ricearcane/ti_contest/Pictures/Haptic_subsystem.jpg

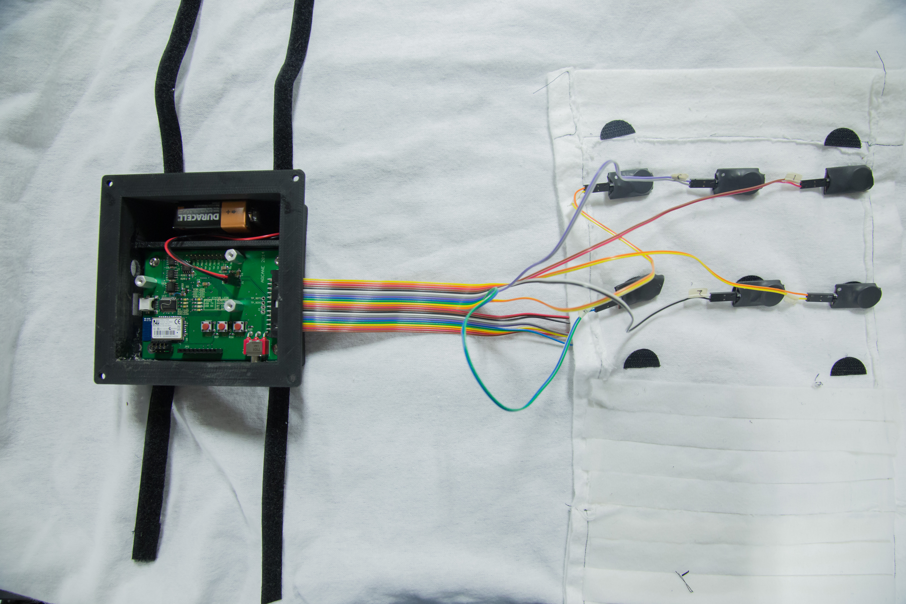
Pictures/Haptic_subsystem.jpg
