ricearcane/ti_contest/README.md

ti_contest
==========

Files for the 2014 TI Analog Design Competition
