ricearcane/ti_contest/Pictures/Stereo_cameras.jpg

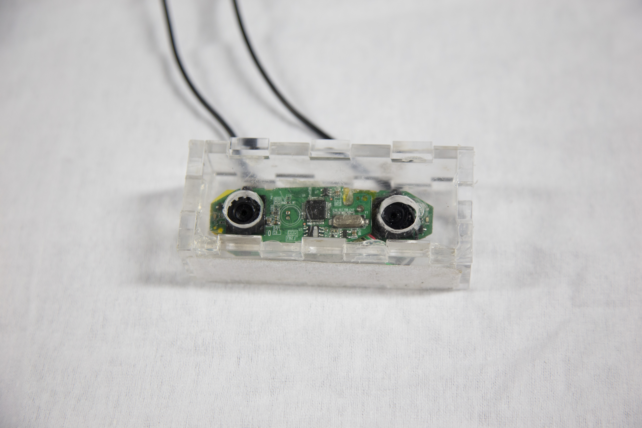
Pictures/Stereo_cameras.jpg
