ricearcane/ti_contest/Hardware/BOMs/battery_charger_bom.xlsx

Value | Device | Package | Parts | Description | Qty | Digikey Part Number | Customer Reference
10m | R-US_R2010 | R2010 | R17 | RESISTOR, American symbol | 1 | RHM.010ASCT-ND | R17
50m | R-US_R2010 | R2010 | R20 | RESISTOR, American symbol | 1 | CSRN2010FK50L0CT-ND | R20
2 | R-US_R2512 | R2512 | R6 | RESISTOR, American symbol | 1 | PT2.0YCT-ND | R6
10 | R-US_R1206 | R1206 | R16 | RESISTOR, American symbol | 1 | 311-10.0FRCT-ND | R16
100 | R-US_R0603 | R0603 | R13 | RESISTOR, American symbol | 1 | 311-100GRCT-ND | R13
1k | R-US_R0603 | R0603 | R15, R18 | RESISTOR, American symbol | 5 | 311-1.00KHRCT-ND | R15, R18 | Extras for LEDs
2.2k | R-US_R0603 | R0603 | R11 | RESISTOR, American symbol | 1 | 311-2.20KHRCT-ND | R11
6.8k | R-US_R0603 | R0603 | R12 | RESISTOR, American symbol | 1 | 311-6.80KHRCT-ND | R12
10k | R-US_R0603 | R0603 | R1, R2, R3 | RESISTOR, American symbol | 3 | 311-10KGRCT-ND | R1, R2, R3
25k | R-US_R0603 | R0603 | R5 | RESISTOR, American symbol | 1 | PNM0603-25KBCT-ND | R5
34k | R-US_R0603 | R0603 | R8 | RESISTOR, American symbol | 1 | RMCF0603FT34K0CT-ND | R8
100k | R-US_R0603 | R0603 | R4, R7, R9, R10, R14, R19, R22 | RESISTOR, American symbol | 7 | 311-100KHRCT-ND | R4, R7, R9, R10, R14, R19, R22
300k | R-US_R0603 | R0603 | R21 | RESISTOR, American symbol | 1 | P300KHCT-ND | R21
22p | C-EUC0603 | C0603 | C17 | CAPACITOR, European symbol | 1 | 445-5366-1-ND | C17
.1u | C-EUC0603 | C0603 | C3, C4, C5, C6, C9, C11, C12, C13, C14 | CAPACITOR, European symbol | 9 | 399-7844-1-ND | C3, C4, C5, C6, C9, C11, C12, C13, C14
1u | C-EUC0603 | C0603 | C2, C7, C10 | CAPACITOR, European symbol | 3 | 587-2400-1-ND | C2, C7, C10
2.2u | C-EUC0603 | C0603 | C1 | CAPACITOR, European symbol | 1 | 445-8025-1-ND | C1
10u | C-EUC0805 | C0805 | C8, C15, C16, C18 | CAPACITOR, European symbol | 4 | 445-11516-1-ND | C8, C15, C16, C18
8.2uH | IHLP-2525CZ-01 | IHLP-2525CZ | L1 |  | 1 | 541-1012-1-ND | L1
Amber | LEDCHIPLED_0805 | LEDCHIPLED_0805 | LED3 | LED | 1 | 516-1431-1-ND | LED3
Blue | LEDCHIPLED_0805 | LEDCHIPLED_0805 | LED1 | LED | 1 | 160-1645-1-ND | LED1
Green | LEDCHIPLED_0805 | CHIPLED_0805 | LED2 | LED | 1 | 160-1423-1-ND | LED2
BAT54C | BAT54C | SOT23 | D1 | Schottky Diodes | 1 | BAT54CT-ND | D1
BQ24630 | BQ24630 | PVQFN-24 | U1 |  | 1 | 296-25761-1-ND | U1
SI7617DN | SI7617DN | POWERPAK1212-8 | Q1, Q2, Q5 |  | 3 | SI7617DN-T1-GE3CT-ND | Q1, Q2, Q5
SIS412DN | SIS412DN | POWERPAK1212-8 | Q3, Q4 |  | 2 | SIS412DN-T1-GE3CT-ND | Q3, Q4
 | 733980-62 | 733980-62 | X1 | FEMALE PRINT CONNECTOR | 1 | CP-047A-ND | X1
 | PINHD-1X2 | 1X02 | JP2, JP3 | PIN HEADER | 2 |  | JP2, JP3
BATTERY | PINHD-1X3 | 1X03 | JP1 | PIN HEADER | 1 |  | JP1
