ricearcane/ti_contest/Hardware/BOMs/integrated_board_bom.xlsx

Value | Device | Package | Parts | Description | Qty | Digikey Part Number | Customer Reference | Notes
1 | R-US_R0805 | R0805 | R6, R7, R8, R9, R10, R11, R12, R13, R14, R15, R16, R17 | RESISTOR, American symbol | 12 | RMCF0805JT1R00CT-ND | R6, R7, R8, R9, R10, R11, R12, R13, R14, R15, R16, R17
330 | R-US_R0603 | R0603 | R20, R21, R22 | RESISTOR, American symbol | 3 | 1276-5050-1-ND | R20, R21, R22
470 | R-US_R0603 | R0603 | R4, R18, R19, R30, R31, R32 | RESISTOR, American symbol | 6 | 311-470GRCT-ND | R4, R18, R19, R30, R31, R32
1.24k | R-US_R0603 | R0603 | R5 | RESISTOR, American symbol | 1 | P1.24KHCT-ND | R5
4.7k | R-US_R0603 | R0603 | R25, R26, R28, R29 | RESISTOR, American symbol | 4 | 311-4.7KGRCT-ND | R25, R26, R28, R29
10k | R-US_R0603 | R0603 | R27, R33 | RESISTOR, American symbol | 2 | 311-10KGRCT-ND | R27, R33
91k | R-US_R0603 | R0603 | R3 | RESISTOR, American symbol | 1 | 311-91.0KHRCT-ND | R3
100k | R-US_R0603 | R0603 | R1 | RESISTOR, American symbol | 1 | 311-100KGRCT-ND | R1
284k | R-US_R0603 | R0603 | R2 | RESISTOR, American symbol | 1 | RR08P284KDCT-ND | R2
4.7k | CTS742C083 | CTS742C083 | RN1 | Chip Resistor Array 4 Single Resistor | 1 | TC164J-4.7KCT-ND | RN1
0.1uF | C-USC0805K | C0805K | C5, C6, C7, C9, C10, C12, C13 | CAPACITOR, American symbol | 7 | 311-1361-1-ND | C5, C6, C7, C9, C10, C12, C13
1uF | C-EUC0805K | C0805K | C3, C4 | CAPACITOR, European symbol | 2 | 1276-1029-1-ND | C3, C4
10uF | C-USC1206K | C1206K | C1 | CAPACITOR, American symbol | 1 | 587-1353-1-ND | C1
22uF | C-USC1206K | C1206K | C2, C8, C11 | CAPACITOR, American symbol | 3 | 1276-3048-1-ND | C2, C8, C11
2.2uH | L-USL2520P | L2520P | L1 | INDUCTOR, American symbol | 1 | 445-3670-1-ND | L1
Amber | LEDCHIP-LED0805 | CHIP-LED0805 | LED8 | LED | 1 | 516-1431-1-ND | LED8
Blue | LEDCHIP-LED0805 | CHIP-LED0805 | LED4 | LED | 1 | 160-1645-1-ND | LED4
Green | LEDCHIP-LED0805 | CHIP-LED0805 | LED3,LED7 | LED | 2 | 160-1423-1-ND | LED3,LED7
Red | LEDCHIP-LED0805 | CHIP-LED0805 | LED1, LED2, LED6, LED9 | LED | 4 | 160-1415-1-ND | LED1, LED2, LED6, LED9
White | LEDCHIP-LED0805 | CHIP-LED0805 | LED5 | LED | 1 | 160-1738-1-ND | LED5
23K256 | 23K256 | SOIC8 | U8, U9 |  | 2 | 23K256-I/SN-ND | U8, U9
24FC512 | 24FC512 | SOIC8 | U10 |  | 1 | 24FC512-I/SN-ND | U10
FT232RL | FT232RL | SSOP28 | U13 |  | 1 | 768-1007-1-ND | U13
P8X32A-Q44 | Propeller | P8X32A-Q44 | U11 |  | 1 | P8X32A-Q44-ND | U11
RN-42 | Bluetooth Module | RN-42 | U6 |  | 1 | 740-1038-ND | U6
SST25VF040B | SST25VF040B | SOIC8 | U12 |  | 1 | 804-25VF040B5CSAF | U12 | MOUSER PART
TLC59711 | TLC59711 | TLC59711 | U3 |  | 1 | 296-36745-1-ND | U3
TPD6E05U06 | TPD6E05U06 | PUQFN-N14 | U2, U4 | TPD6E05U06 6-channel ESD Protection device | 2 | N/A | U2, U4 | New product - need to sample from TI
TPS62160 | TPS62160 | VSSOP | U1 |  | 1 | 296-30318-1-ND | U1
2524-5 | 2524-5 | PAK100/2500-5-24 | J3 | 3M (TM) Pak 100 4-Wall Header | 1 | MHE24K-ND | J3
1X02 Header Male | PINHD-1X2 | 1X02 | J1, J2 | PIN HEADER | 2 |  | J1, J2
1X09 Header | PINHD-1X9 | 1X09 | JP2 | PIN HEADER | 1 |  | JP2
 | JP4Q | JP4Q | JP1 | JUMPER | 4 | 3M9580-ND | JP1
 | PUSHBUTTON | 6MMX6MM | SW1, SW2, SW3 |  | 3 | 450-1804-ND | SW1, SW2, SW3
 | 7101MD9AQE | 7101MD9A | S1 | TOGGLE SWITCH | 1 | CKN1047-ND | S1
5MHz | CRYSTALHC49UP | HC49UP | Q1 | CRYSTAL | 1 | XC1264CT-ND | Q1
SOT23-3904 | MMBT918LT1-NPN-SOT23-BEC | SOT23-BEC | Q2 | NPN Transistror | 1 | MMBT918LT1GOSCT-ND | Q2
USB-MINI_B | USB-MINI_B | USB_MINI_B | J4 | MINI USB-B Conector | 1 | H2959CT-ND | J4
