ricearcane/ti_contest/Hardware/Battery Charger/charger_brd.pdf

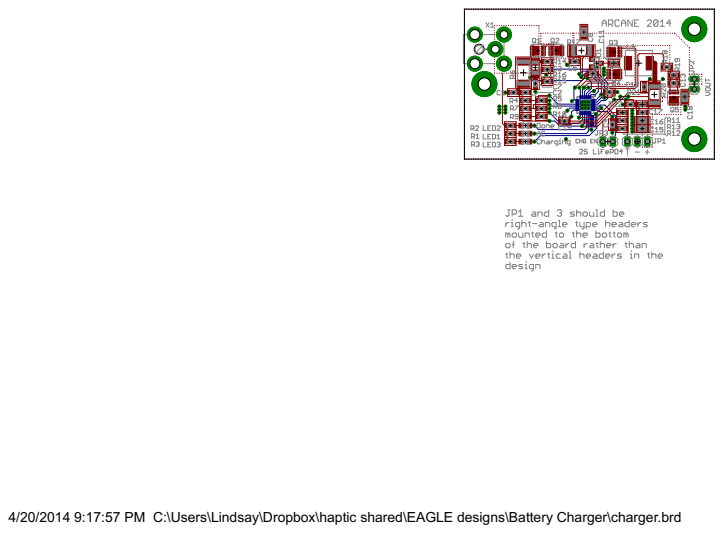
[picture p28: page 1]

4/20/2014 9:17:57 PM C:\Users\Lindsay\Dropbox\haptic shared\EAGLE designs\Battery Charger\charger.brd
