ricearcane/ti_contest/Hardware/Battery Charger/charger_sch.pdf

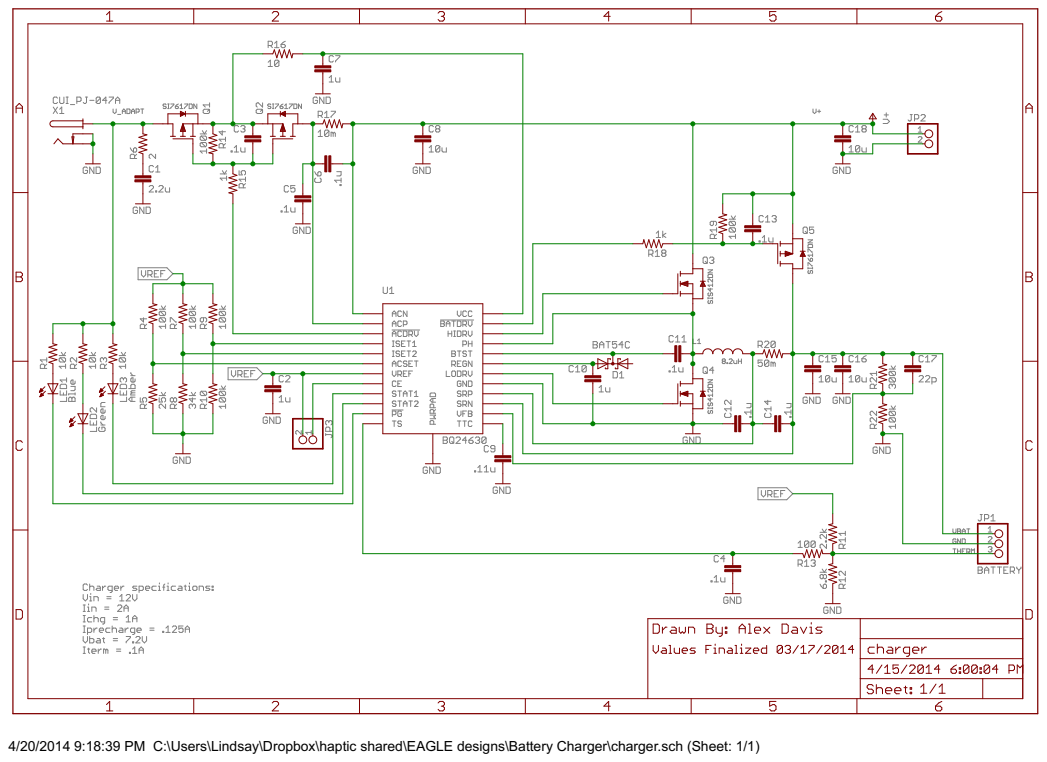
[picture p29: page 1]

4/20/2014 9:18:39 PM C:\Users\Lindsay\Dropbox\haptic shared\EAGLE designs\Battery Charger\charger.sch (Sheet: 1/1)
