ricearcane/ti_contest/Hardware/Integrated haptic system/integrated_haptic_brd.pdf

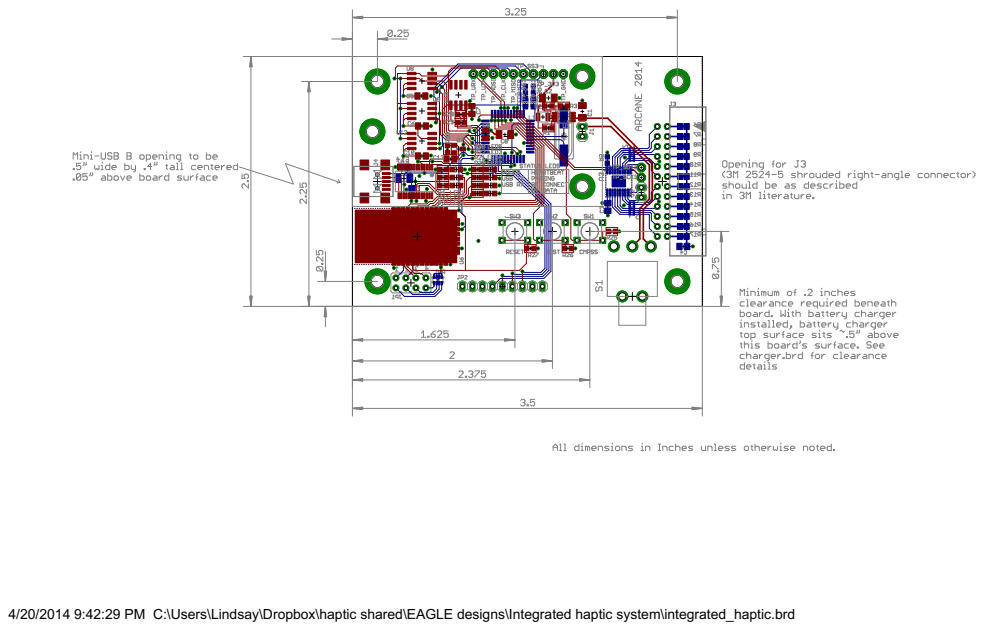
[picture p30: page 1]

4/20/2014 9:42:29 PM C:\Users\Lindsay\Dropbox\haptic shared\EAGLE designs\Integrated haptic system\integrated_haptic.brd
