ricearcane/ti_contest/Hardware/Integrated haptic system/integrated_haptic_sch.pdf

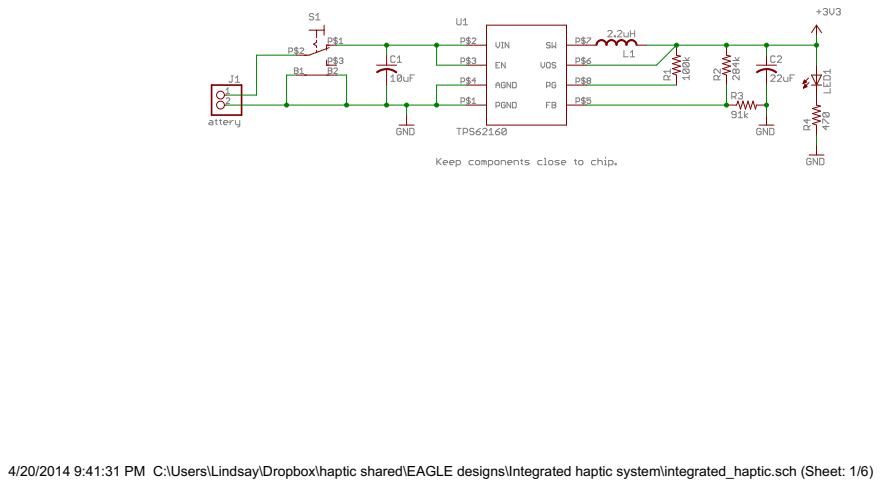
[picture p31: page 1]

4/20/2014 9:41:31 PM C:\Users\Lindsay\Dropbox\haptic shared\EAGLE designs\Integrated haptic system\integrated_haptic.sch (Sheet: 1/6)

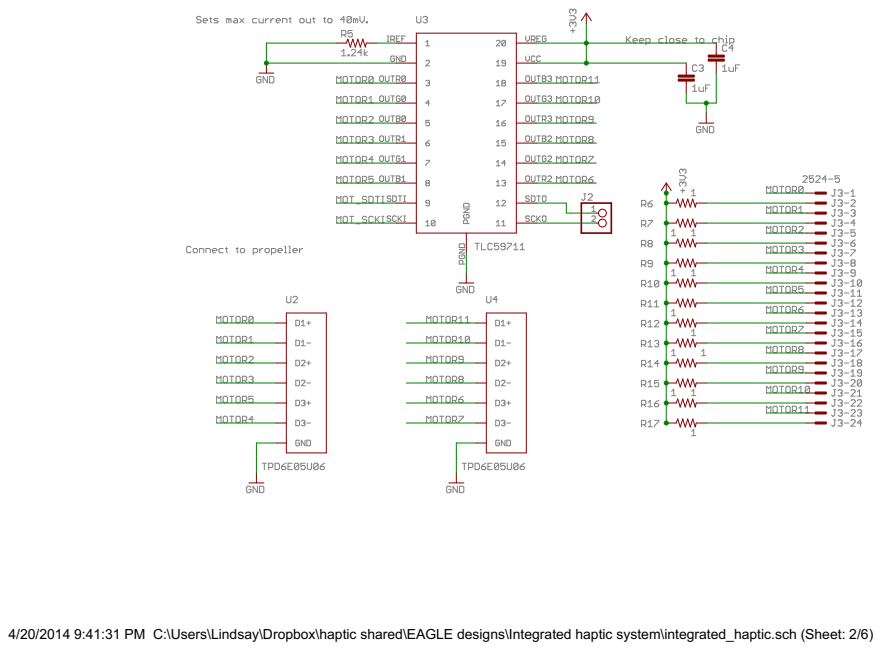
[picture p32: page 2]

4/20/2014 9:41:31 PM C:\Users\Lindsay\Dropbox\haptic shared\EAGLE designs\Integrated haptic system\integrated_haptic.sch (Sheet: 2/6)

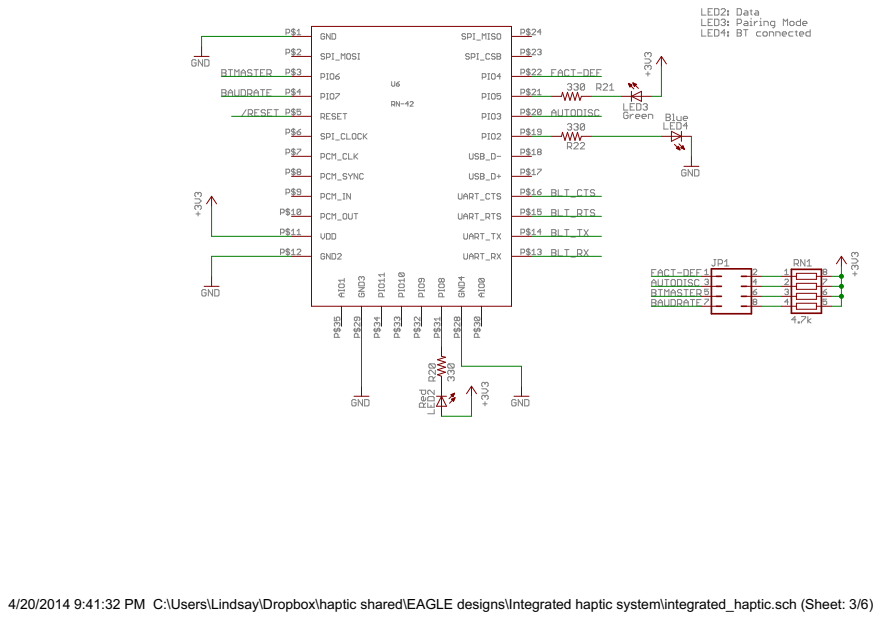
[picture p33: page 3]

4/20/2014 9:41:32 PM C:\Users\Lindsay\Dropbox\haptic shared\EAGLE designs\Integrated haptic system\integrated_haptic.sch (Sheet: 3/6)

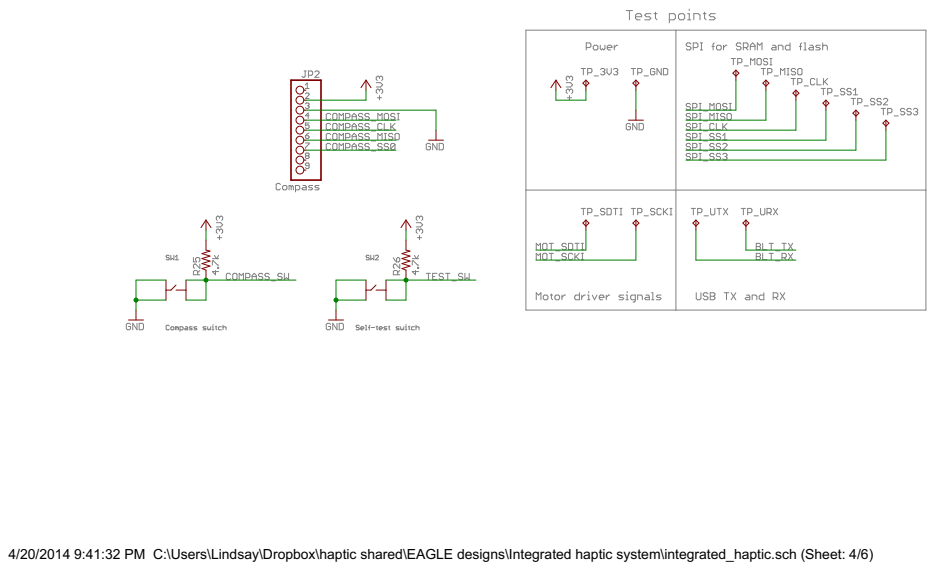
[picture p34: page 4]

4/20/2014 9:41:32 PM C:\Users\Lindsay\Dropbox\haptic shared\EAGLE designs\Integrated haptic system\integrated_haptic.sch (Sheet: 4/6)

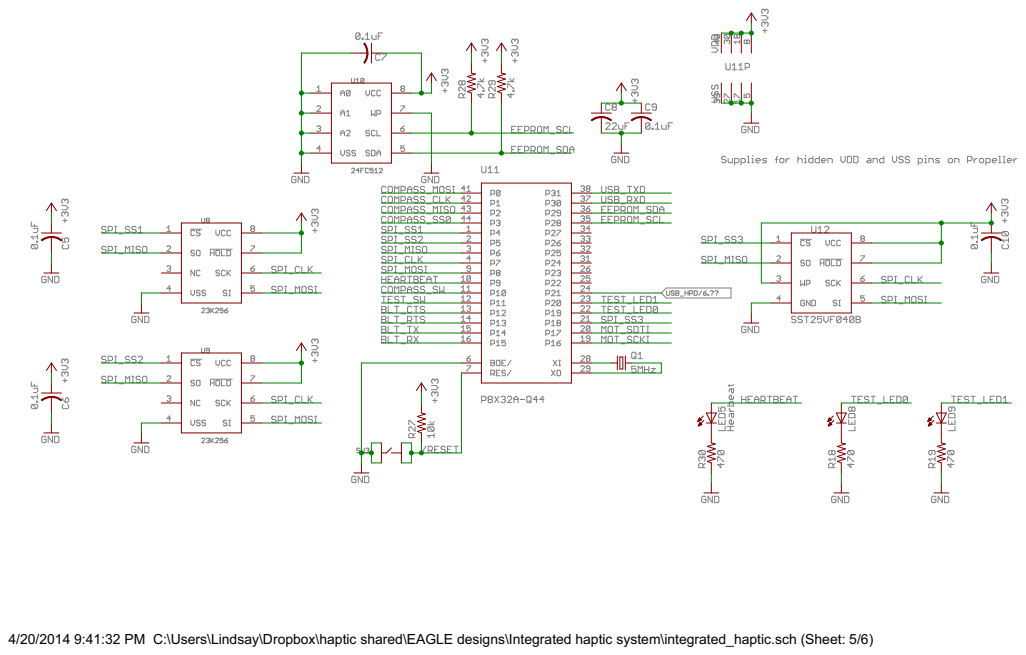
[picture p35: page 5]

4/20/2014 9:41:32 PM C:\Users\Lindsay\Dropbox\haptic shared\EAGLE designs\Integrated haptic system\integrated_haptic.sch (Sheet: 5/6)

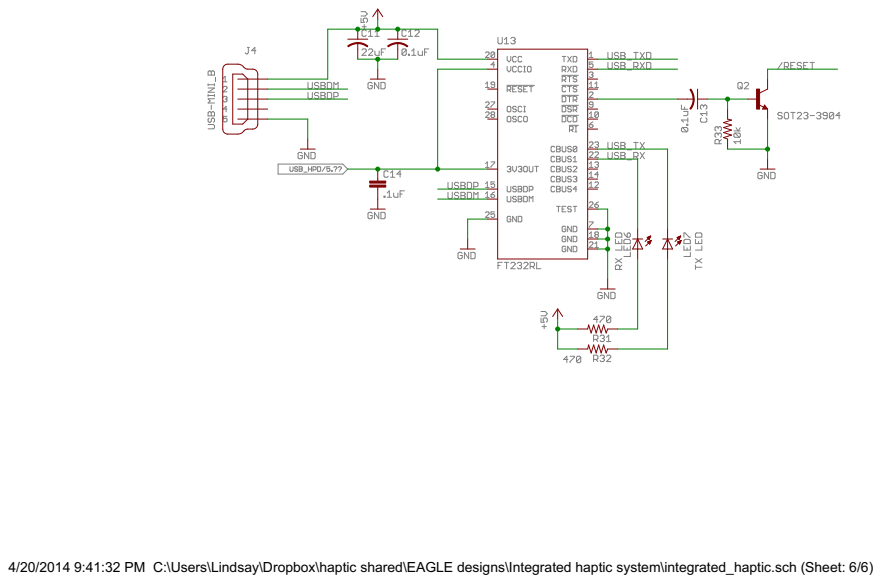
[picture p36: page 6]

4/20/2014 9:41:32 PM C:\Users\Lindsay\Dropbox\haptic shared\EAGLE designs\Integrated haptic system\integrated_haptic.sch (Sheet: 6/6)
