ricearcane/ti_contest/Hardware/Motor Coupons/coupon-brd.pdf

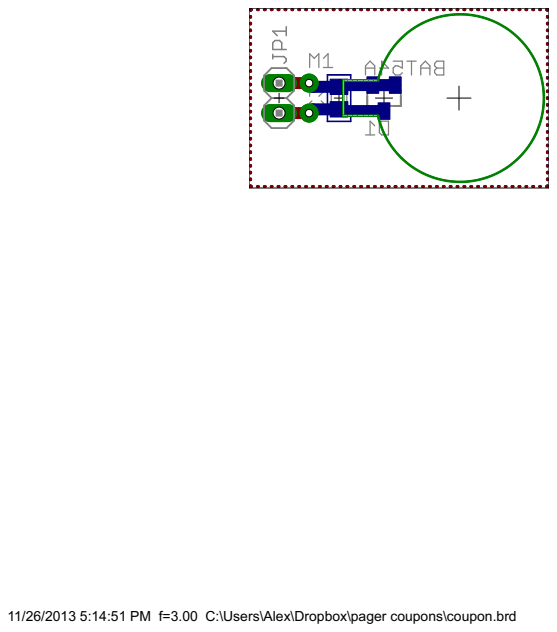
[picture p37: page 1]

11/26/2013 5:14:51 PM f=3.00 C:\Users\Alex\Dropbox\pager coupons\coupon.brd
