ricearcane/ti_contest/Hardware/Motor Coupons/coupon-sch.pdf

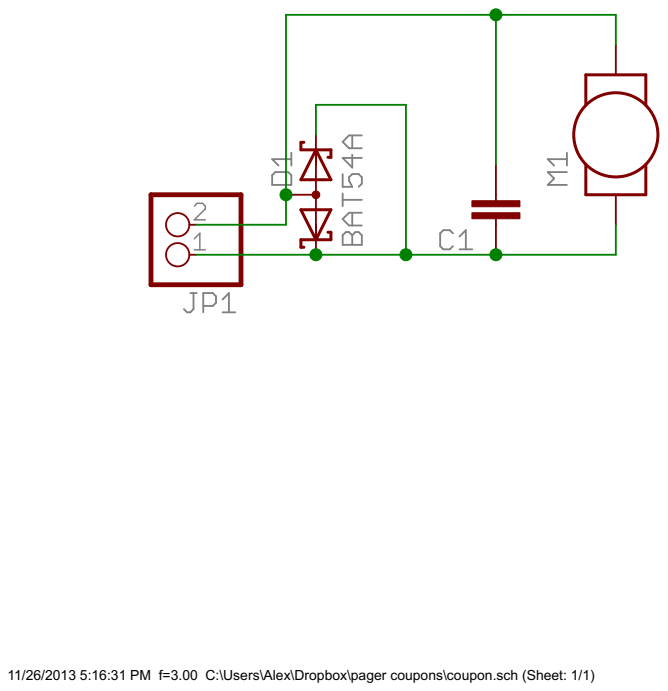
[picture p38: page 1]

11/26/2013 5:16:31 PM f=3.00 C:\Users\Alex\Dropbox\pager coupons\coupon.sch (Sheet: 1/1)
