ricearcane/ti_contest/Hardware/Motor Coupons/coupon.brd

## EAGLE design Hardware/Motor Coupons/coupon.brd (2014-05-25)

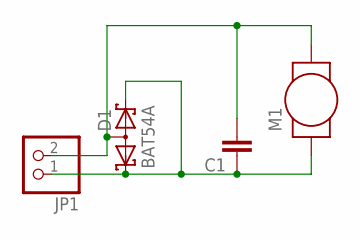
[picture p39: schematic coupon.sch]

Parts:
C1: C-EUC0805; C0805
D1: BAT54A; SOT23
JP1: PINHD-1X2; 1X02
M1: PAGER-PANCAKE; PANCAKE

Connections:
GND: C1.1, D1.1 (K1), D1.2 (K2), JP1.1, M1.P$1
unnamed: C1.2, D1.3 (AA), JP1.2, M1.P$2

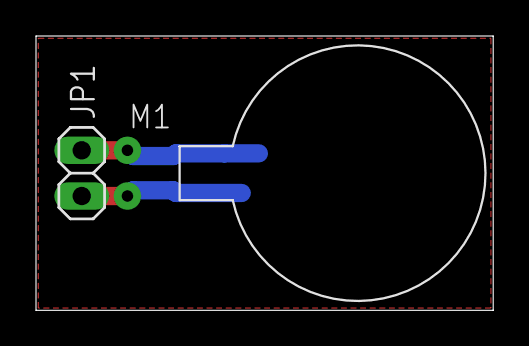
[picture p40: board coupon.brd from above]

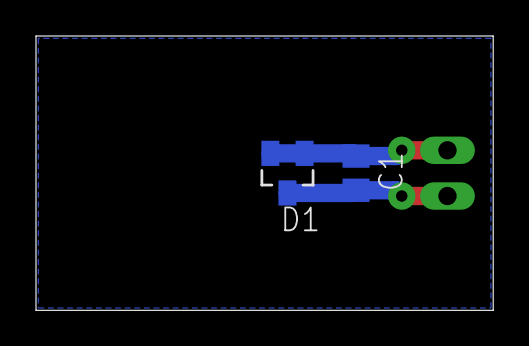
[picture p41: board coupon.brd from below]

Board: 2 copper layers, 25.4 x 15.2 mm, 4 parts (2 on the bottom side), 2 nets.
