ricearcane/ti_contest/Hardware/Integrated haptic system/integrated_haptic.brd

## EAGLE design Hardware/Integrated haptic system/integrated_haptic.brd (2014-05-25)

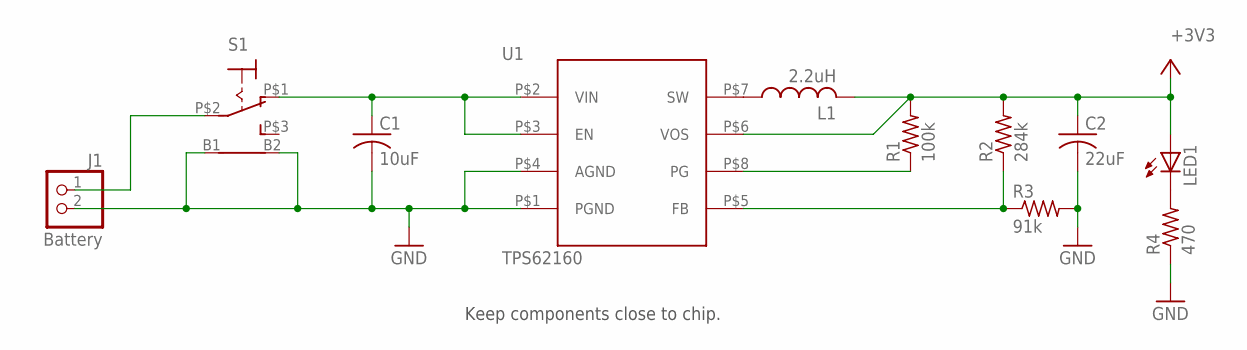
[picture p42: schematic integrated_haptic.sch, sheet 1]

Parts:
C1: 10uF; C1206K
C2: 22uF; C1206K
J1: Battery; 1X02
L1: 2.2uH; L2520P
LED1: LEDCHIP-LED0805; CHIP-LED0805
R1: 100k; R0603
R2: 284k; R0603
R3: 91k; R0603
R4: 470; R0603
S1: 7101MD9AQE; 7101MD9A
U1: TPS62160; VSSOP

Connections:
+3V3: C2.1, L1.2, LED1.A, R1.2, R2.2, U1.P$6 (VOS); also elsewhere on the board
GND: C1.2, C2.2, J1.2, R3.2, R4.1, S1.B1 (B), S1.B2 (B1), U1.P$1 (PGND), U1.P$4 (AGND); also elsewhere on the board
unnamed: L1.1, U1.P$7 (SW)
unnamed: J1.1, S1.P$2
unnamed: LED1.C, R4.2
unnamed: R2.1, R3.1, U1.P$5 (FB)
POWER_PG: R1.1, U1.P$8 (PG)
VBAT: C1.1, S1.P$1 (O), U1.P$2 (VIN), U1.P$3 (EN)

Notes on the sheet:
Keep components close to chip.

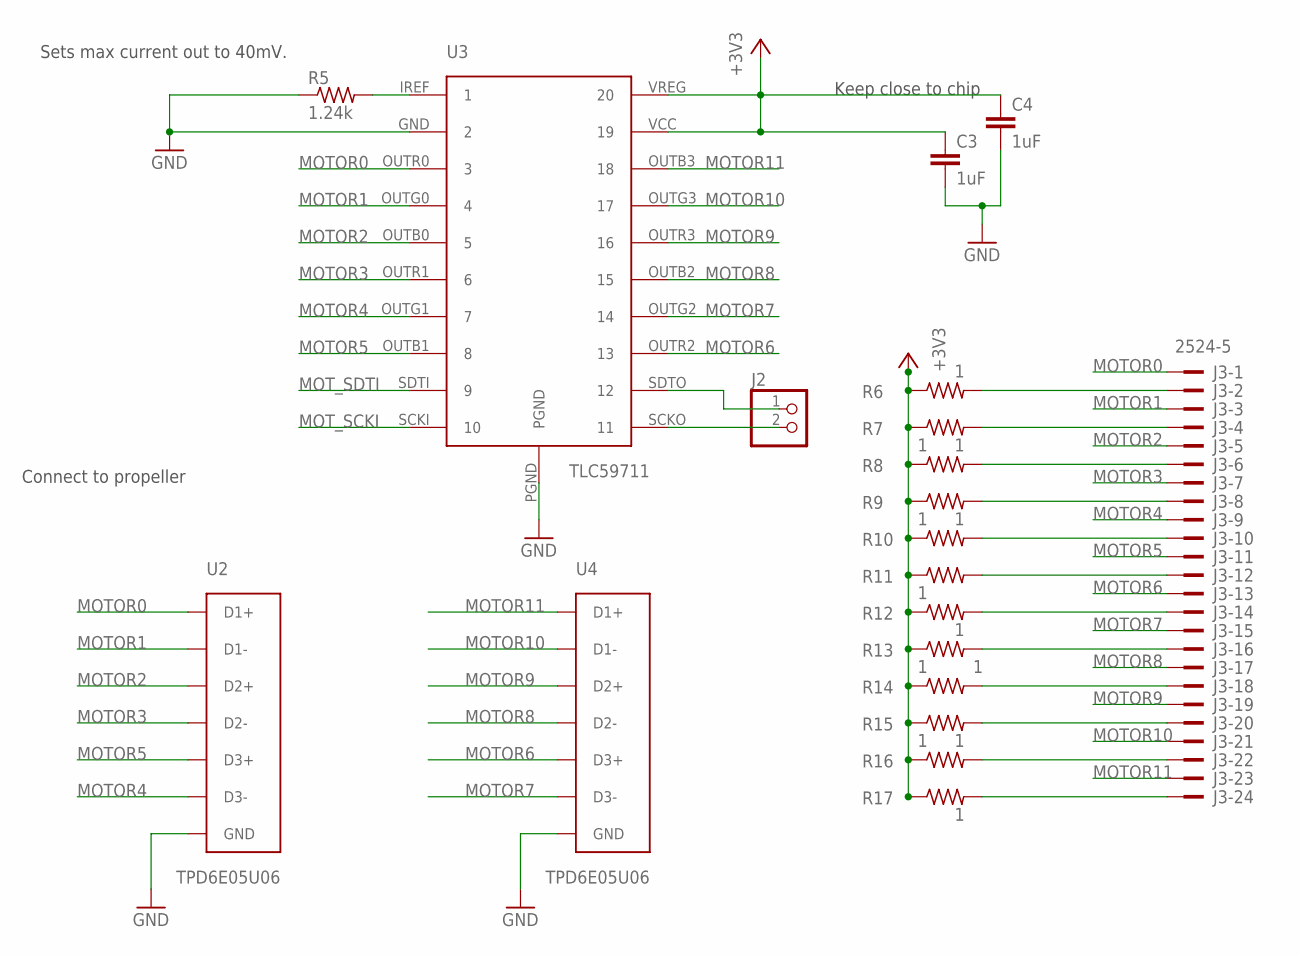
[picture p43: schematic integrated_haptic.sch, sheet 2]

Parts:
C3, C4: 1uF; C0805K
J2: PINHD-1X2; 1X02
J3: 2524-5; PAK100/2500-5-24
R5: 1.24k; R0603
R6, R7, R8, R9, R10, R11, R12, R13, R14, R15, R16, R17: 1; R0805
U2, U4: TPD6E05U06; PUQFN-N14
U3: TLC59711

Connections:
+3V3: C3.1, C4.1, R6.1, R7.1, R8.1, R9.1, R10.1, R11.1, R12.1, R13.1, R14.1, R15.1, R16.1, R17.1, U3.VCC (19), U3.VREG (20); also elsewhere on the board
GND: C3.2, C4.2, R5.1, U2.P$5 (GND), U2.P$10 (GND), U3.GND (2), U3.PGND, U4.P$5 (GND), U4.P$10 (GND); also elsewhere on the board
MOTOR0: J3.1, U2.P$1 (D1+), U2.P$14 (D1+), U3.OUTR0 (3)
MOTOR1: J3.3, U2.P$2 (D1-), U2.P$13 (D1-), U3.OUTG0 (4)
MOTOR2: J3.5, U2.P$3 (D2+), U2.P$12 (D2+), U3.OUTB0 (5)
MOTOR3: J3.7, U2.P$4 (D2-), U2.P$11 (D2-), U3.OUTR1 (6)
MOTOR4: J3.9, U2.P$6 (D3-), U2.P$9 (D3-), U3.OUTG1 (7)
MOTOR5: J3.11, U2.P$7 (D3+), U2.P$8 (D3+), U3.OUTB1 (8)
MOTOR6: J3.13, U3.OUTR2 (13), U4.P$7 (D3+), U4.P$8 (D3+)
MOTOR7: J3.15, U3.OUTG2 (14), U4.P$6 (D3-), U4.P$9 (D3-)
MOTOR8: J3.17, U3.OUTB2 (15), U4.P$4 (D2-), U4.P$11 (D2-)
MOTOR9: J3.19, U3.OUTR3 (16), U4.P$3 (D2+), U4.P$12 (D2+)
MOTOR10: J3.21, U3.OUTG3 (17), U4.P$2 (D1-), U4.P$13 (D1-)
MOTOR11: J3.23, U3.OUTB3 (18), U4.P$1 (D1+), U4.P$14 (D1+)
MOT_SCKI: U3.SCKI (10); also elsewhere on the board
MOT_SDTI: U3.SDTI (9); also elsewhere on the board
unnamed: R5.2, U3.IREF (1)
unnamed: J3.24, R17.2
unnamed: J3.22, R16.2
unnamed: J3.20, R15.2
unnamed: J3.18, R14.2
unnamed: J3.16, R13.2
unnamed: J3.14, R12.2
unnamed: J3.12, R11.2
unnamed: J3.10, R10.2
unnamed: J3.8, R9.2
unnamed: J3.6, R8.2
unnamed: J3.4, R7.2
unnamed: J3.2, R6.2
unnamed: J2.2, U3.SCKO (11)
unnamed: J2.1, U3.SDTO (12)

Notes on the sheet:
Sets max current out to 40mV.
Keep close to chip
Connect to propeller

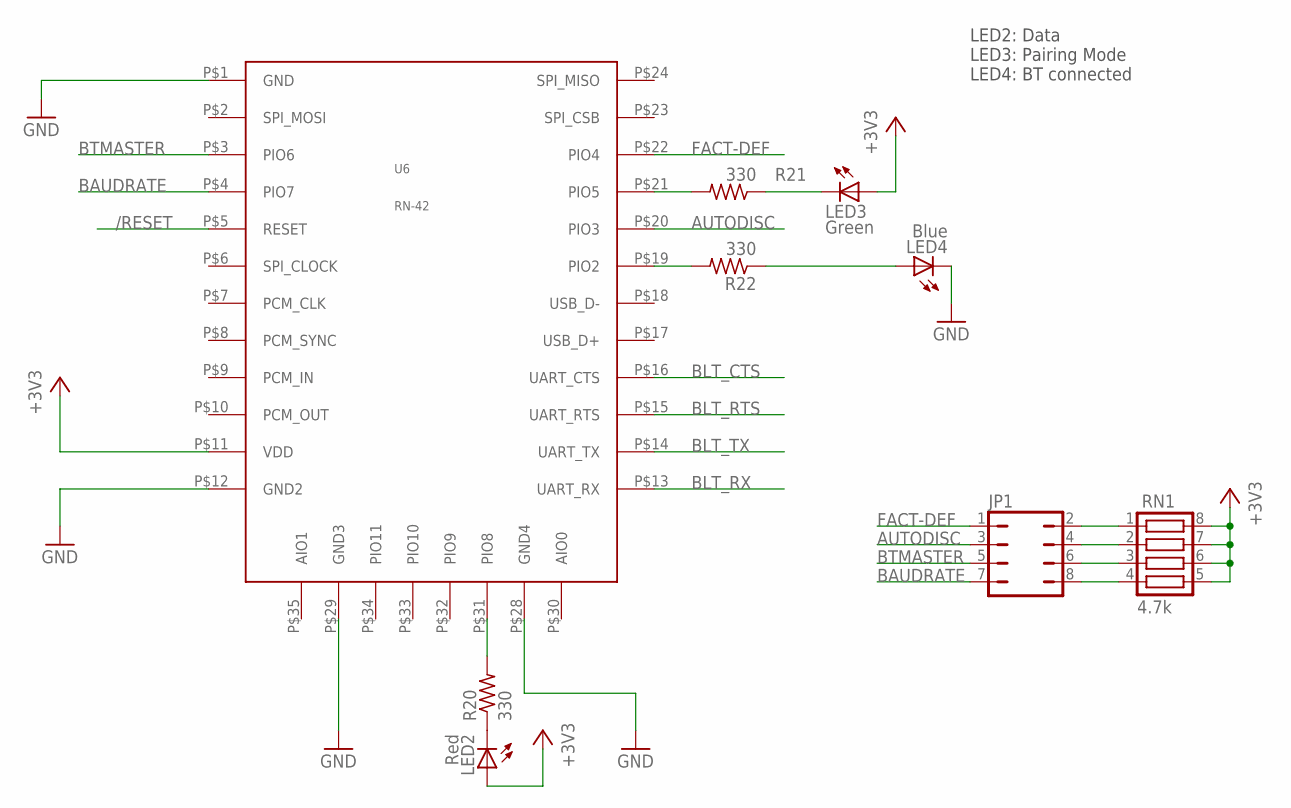
[picture p44: schematic integrated_haptic.sch, sheet 3]

Parts:
JP1: JP4Q
LED2: Red; CHIP-LED0805
LED3: Green; CHIP-LED0805
LED4: Blue; CHIP-LED0805
R20, R21, R22: 330; R0603
RN1: 4.7k; CTS742C083
U6: RN-42

Connections:
+3V3: LED2.A, LED3.A, RN1.5, RN1.6, RN1.7, RN1.8, U6.P$11 (VDD); also elsewhere on the board
/RESET: U6.P$5 (RESET); also elsewhere on the board
AUTODISC: JP1.3, U6.P$20 (PIO3)
BAUDRATE: JP1.7, U6.P$4 (PIO7)
BLT_CTS: U6.P$16 (UART_CTS); also elsewhere on the board
BLT_RTS: U6.P$15 (UART_RTS); also elsewhere on the board
BLT_RX: U6.P$13 (UART_RX); also elsewhere on the board
BLT_TX: U6.P$14 (UART_TX); also elsewhere on the board
BTMASTER: JP1.5, U6.P$3 (PIO6)
FACT-DEF: JP1.1, U6.P$22 (PIO4)
GND: LED4.C, U6.P$1 (GND), U6.P$12 (GND2), U6.P$28 (GND4), U6.P$29 (GND3); also elsewhere on the board
unnamed: LED2.C, R20.1
unnamed: R21.2, U6.P$21 (PIO5)
unnamed: LED3.C, R21.1
unnamed: R22.2, U6.P$19 (PIO2)
unnamed: LED4.A, R22.1
unnamed: R20.2, U6.P$31 (PIO8)
unnamed: JP1.8, RN1.4
unnamed: JP1.6, RN1.3
unnamed: JP1.4, RN1.2
unnamed: JP1.2, RN1.1

Notes on the sheet:
LED2: Data LED3: Pairing Mode LED4: BT connected

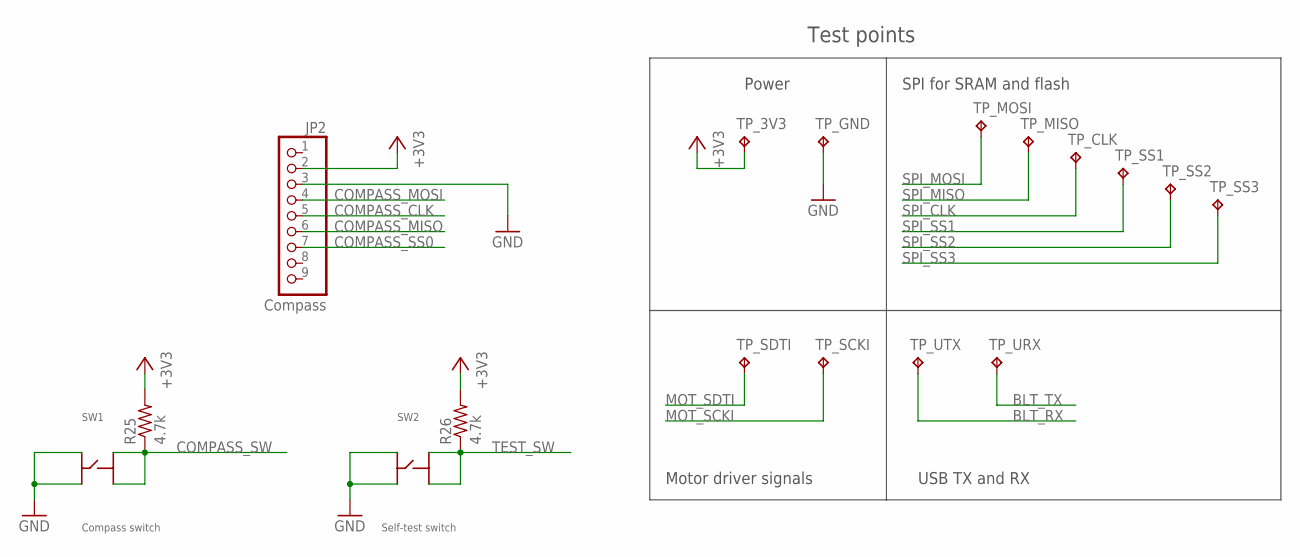
[picture p45: schematic integrated_haptic.sch, sheet 4]

Parts:
JP2: Compass; 1X09
R25, R26: 4.7k; R0603
SW1: Compass switch; 6MMX6MM
SW2: Self-test switch; 6MMX6MM
TP_3V3: TPPAD1-13; P1-13
TP_CLK: TPPAD1-13; P1-13
TP_GND: TPPAD1-13; P1-13
TP_MISO: TPPAD1-13; P1-13
TP_MOSI: SPI_MOSI; P1-13
TP_SCKI: TPPAD1-13; P1-13
TP_SDTI: TPPAD1-13; P1-13
TP_SS1, TP_SS2, TP_SS3: TPPAD1-13; P1-13
TP_URX: TPPAD1-13; P1-13
TP_UTX: TPPAD1-13; P1-13

Connections:
+3V3: JP2.2, R25.2, R26.2, TP_3V3.TP; also elsewhere on the board
BLT_RX: TP_UTX.TP; also elsewhere on the board
BLT_TX: TP_URX.TP; also elsewhere on the board
COMPASS_CLK: JP2.5; also elsewhere on the board
COMPASS_MISO: JP2.6; also elsewhere on the board
COMPASS_MOSI: JP2.4; also elsewhere on the board
COMPASS_SS0: JP2.7; also elsewhere on the board
COMPASS_SW: R25.1, SW1.P$2, SW1.P$4; also elsewhere on the board
GND: JP2.3, SW1.P$1, SW1.P$3, SW2.P$1, SW2.P$3, TP_GND.TP; also elsewhere on the board
MOT_SCKI: TP_SCKI.TP; also elsewhere on the board
MOT_SDTI: TP_SDTI.TP; also elsewhere on the board
SPI_CLK: TP_CLK.TP; also elsewhere on the board
SPI_MISO: TP_MISO.TP; also elsewhere on the board
SPI_MOSI: TP_MOSI.TP; also elsewhere on the board
SPI_SS1: TP_SS1.TP; also elsewhere on the board
SPI_SS2: TP_SS2.TP; also elsewhere on the board
SPI_SS3: TP_SS3.TP; also elsewhere on the board
TEST_SW: R26.1, SW2.P$2, SW2.P$4; also elsewhere on the board

Notes on the sheet:
Power
SPI for SRAM and flash
Motor driver signals
USB TX and RX
Test points

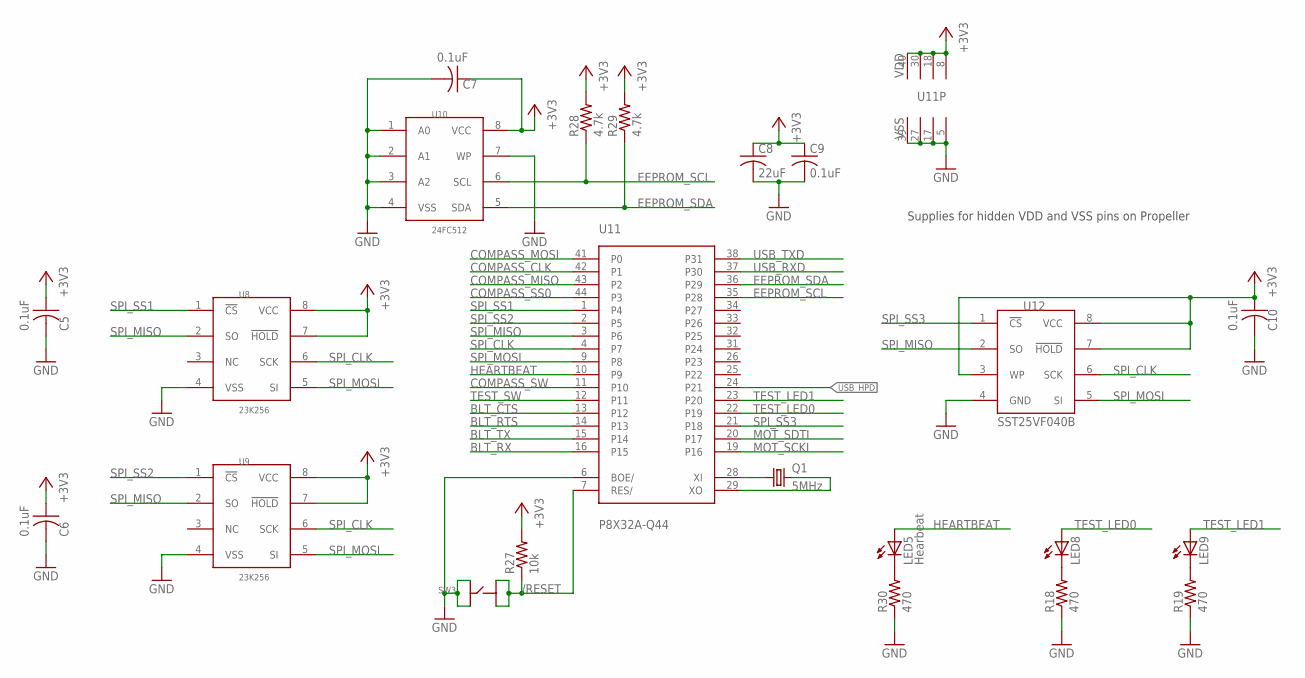
[picture p46: schematic integrated_haptic.sch, sheet 5]

Parts:
C5, C6, C7, C9, C10: 0.1uF; C0805K
C8: 22uF; C1206K
LED5: Hearbeat; CHIP-LED0805
LED8, LED9: LEDCHIP-LED0805; CHIP-LED0805
Q1: 5MHz; HC49UP
R18, R19, R30: 470; R0603
R27: 10k; R0603
R28, R29: 4.7k; R0603
SW3: PUSHBUTTON; 6MMX6MM
U8, U9: 23K256; SOIC8
U10: 24FC512; SOIC8
U11: P8X32A-Q44
U12: SST25VF040B; SOIC8

Connections:
+3V3: C5.1, C6.1, C7.1, C8.1, C9.1, C10.1, R27.2, R28.2, R29.2, U8.7 (!HOLD), U8.8 (VCC), U9.7 (!HOLD), U9.8 (VCC), U10.8 (VCC), U11.8 (VDD), U11.18 (VDD), U11.30 (VDD), U11.40 (VDD), U12.3 (WP), U12.7 (!HOLD), U12.8 (VCC); also elsewhere on the board
/RESET: R27.1, SW3.P$2, SW3.P$4, U11.7 (RES/); also elsewhere on the board
BLT_CTS: U11.13 (P12); also elsewhere on the board
BLT_RTS: U11.14 (P13); also elsewhere on the board
BLT_RX: U11.16 (P15); also elsewhere on the board
BLT_TX: U11.15 (P14); also elsewhere on the board
COMPASS_CLK: U11.42 (P1); also elsewhere on the board
COMPASS_MISO: U11.43 (P2); also elsewhere on the board
COMPASS_MOSI: U11.41 (P0); also elsewhere on the board
COMPASS_SS0: U11.44 (P3); also elsewhere on the board
COMPASS_SW: U11.11 (P10); also elsewhere on the board
EEPROM_SCL: R28.1, U10.6 (SCL), U11.35 (P28)
EEPROM_SDA: R29.1, U10.5 (SDA), U11.36 (P29)
GND: C5.2, C6.2, C7.2, C8.2, C9.2, C10.2, R18.1, R19.1, R30.1, SW3.P$1, SW3.P$3, U8.4 (VSS), U9.4 (VSS), U10.1 (A0), U10.2 (A1), U10.3 (A2), U10.4 (VSS), U10.7 (WP), U11.5 (VSS), U11.6 (BOE/), U11.17 (VSS), U11.27 (VSS), U11.39 (VSS), U12.4 (GND); also elsewhere on the board
HEARTBEAT: LED5.A, U11.10 (P9)
MOT_SCKI: U11.19 (P16); also elsewhere on the board
MOT_SDTI: U11.20 (P17); also elsewhere on the board
unnamed: LED8.C, R18.2
unnamed: LED5.C, R30.2
unnamed: LED9.C, R19.2
SPI_CLK: U8.6 (SCK), U9.6 (SCK), U11.4 (P7), U12.6 (SCK); also elsewhere on the board
SPI_MISO: U8.2 (SO), U9.2 (SO), U11.3 (P6), U12.2 (SO); also elsewhere on the board
SPI_MOSI: U8.5 (SI), U9.5 (SI), U11.9 (P8), U12.5 (SI); also elsewhere on the board
SPI_SS1: U8.1 (!CS), U11.1 (P4); also elsewhere on the board
SPI_SS2: U9.1 (!CS), U11.2 (P5); also elsewhere on the board
SPI_SS3: U11.21 (P18), U12.1 (!CS); also elsewhere on the board
TEST_LED0: LED8.A, U11.22 (P19)
TEST_LED1: LED9.A, U11.23 (P20)
TEST_SW: U11.12 (P11); also elsewhere on the board
USB_HPD: U11.24 (P21); also elsewhere on the board
USB_RXD: U11.37 (P30); also elsewhere on the board
USB_TXD: U11.38 (P31); also elsewhere on the board
XTAL0: Q1.2, U11.29 (XO)
XTAL1: Q1.1, U11.28 (XI)

Notes on the sheet:
Supplies for hidden VDD and VSS pins on Propeller

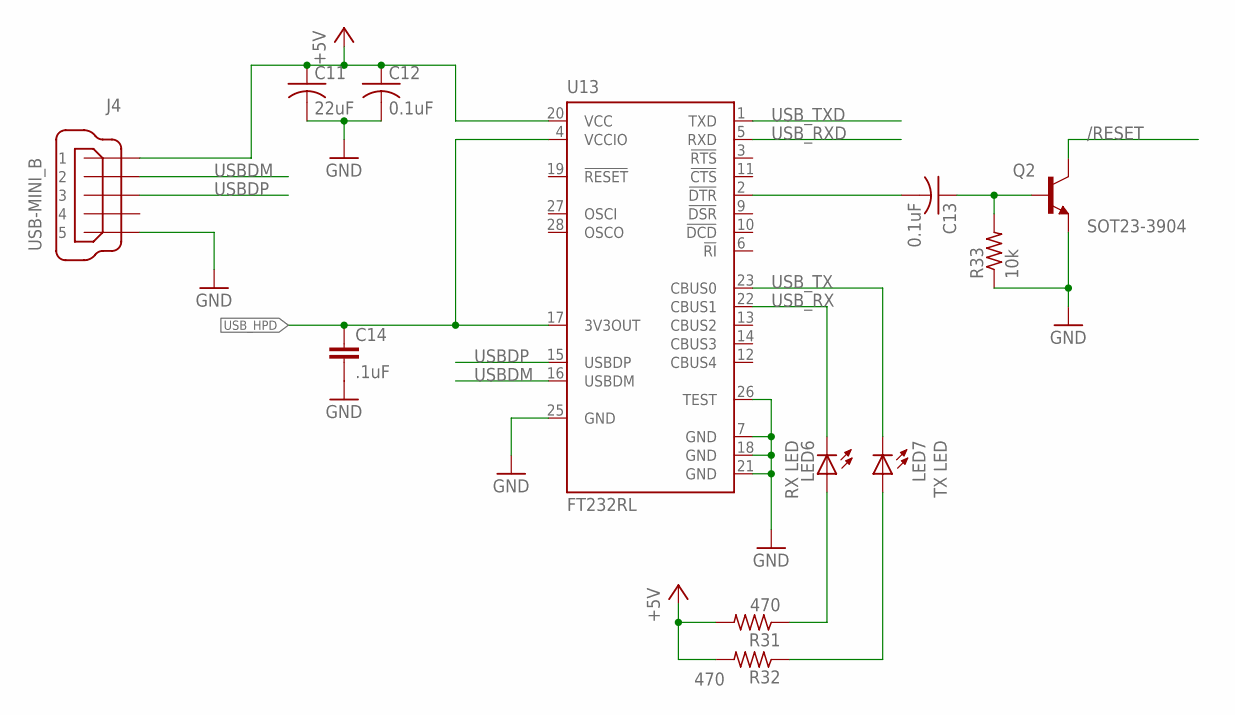
[picture p47: schematic integrated_haptic.sch, sheet 6]

Parts:
C11: 22uF; C1206K
C12, C13: 0.1uF; C0805K
C14: .1uF; C0805
J4: USB-MINI_B; USB_MINI_B
LED6: RX LED; CHIP-LED0805
LED7: TX LED; CHIP-LED0805
Q2: SOT23-3904; SOT23-BEC
R31, R32: 470; R0603
R33: 10k; R0603
U13: FT232RL; SSOP28

Connections:
+5V: C11.1, C12.1, J4.1, R31.2, R32.2, U13.20 (VCC)
/RESET: Q2.C; also elsewhere on the board
GND: C11.2, C12.2, C14.2, J4.5, Q2.E, R33.1, U13.7 (GND), U13.18 (GND), U13.21 (GND), U13.25 (GND), U13.26 (TEST); also elsewhere on the board
unnamed: C13.2, U13.2 (!DTR)
unnamed: LED6.A, R31.1
unnamed: LED7.A, R32.1
unnamed: C13.1, Q2.B, R33.2
USBDM: J4.2, U13.16 (USBDM)
USBDP: J4.3, U13.15 (USBDP)
USB_HPD: C14.1, U13.4 (VCCIO), U13.17 (3V3OUT); also elsewhere on the board
USB_RX: LED6.C, U13.22 (CBUS1)
USB_RXD: U13.5 (RXD); also elsewhere on the board
USB_TX: LED7.C, U13.23 (CBUS0)
USB_TXD: U13.1 (TXD); also elsewhere on the board

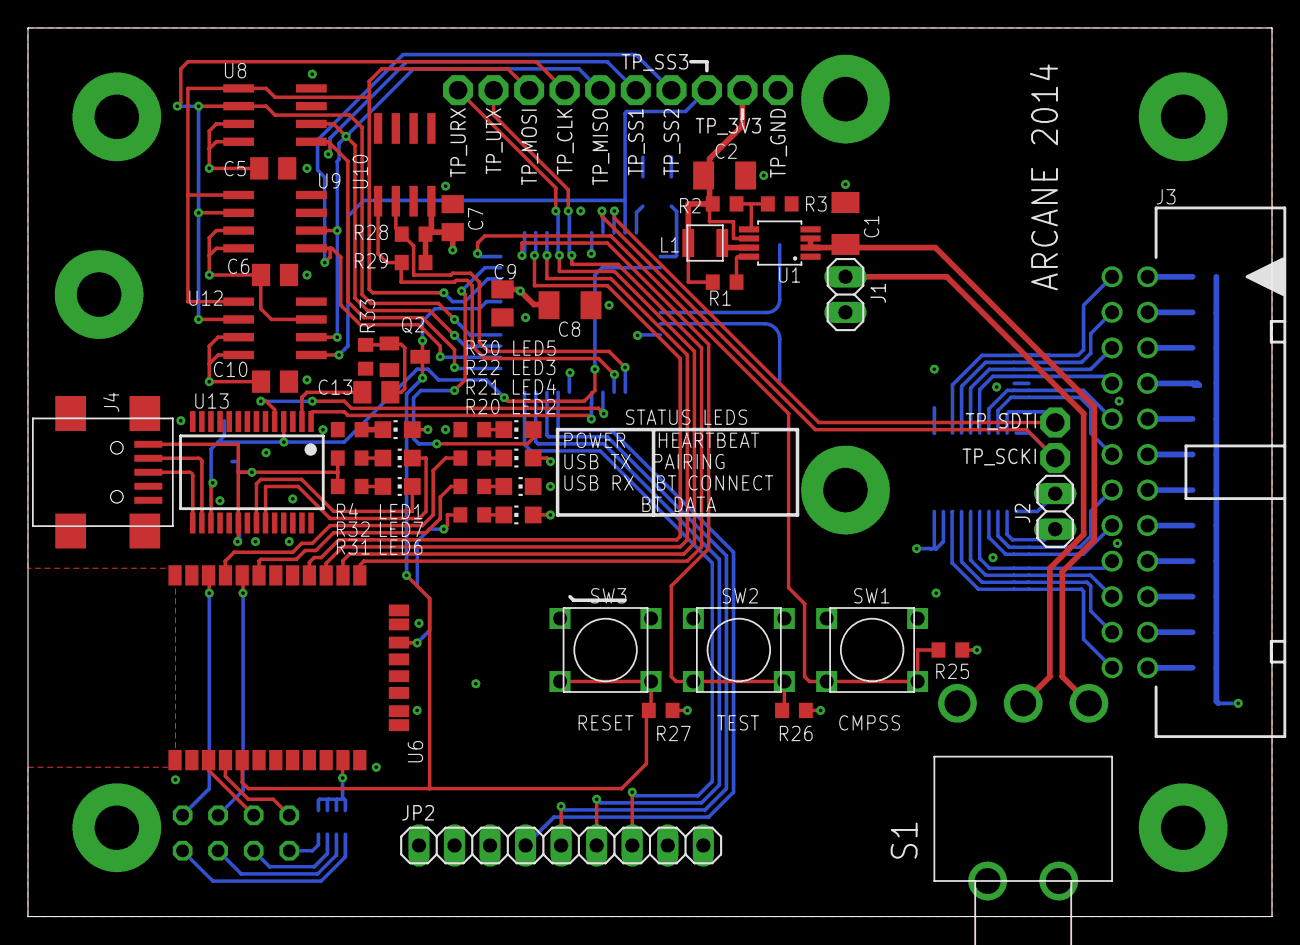
[picture p48: board integrated_haptic.brd from above]

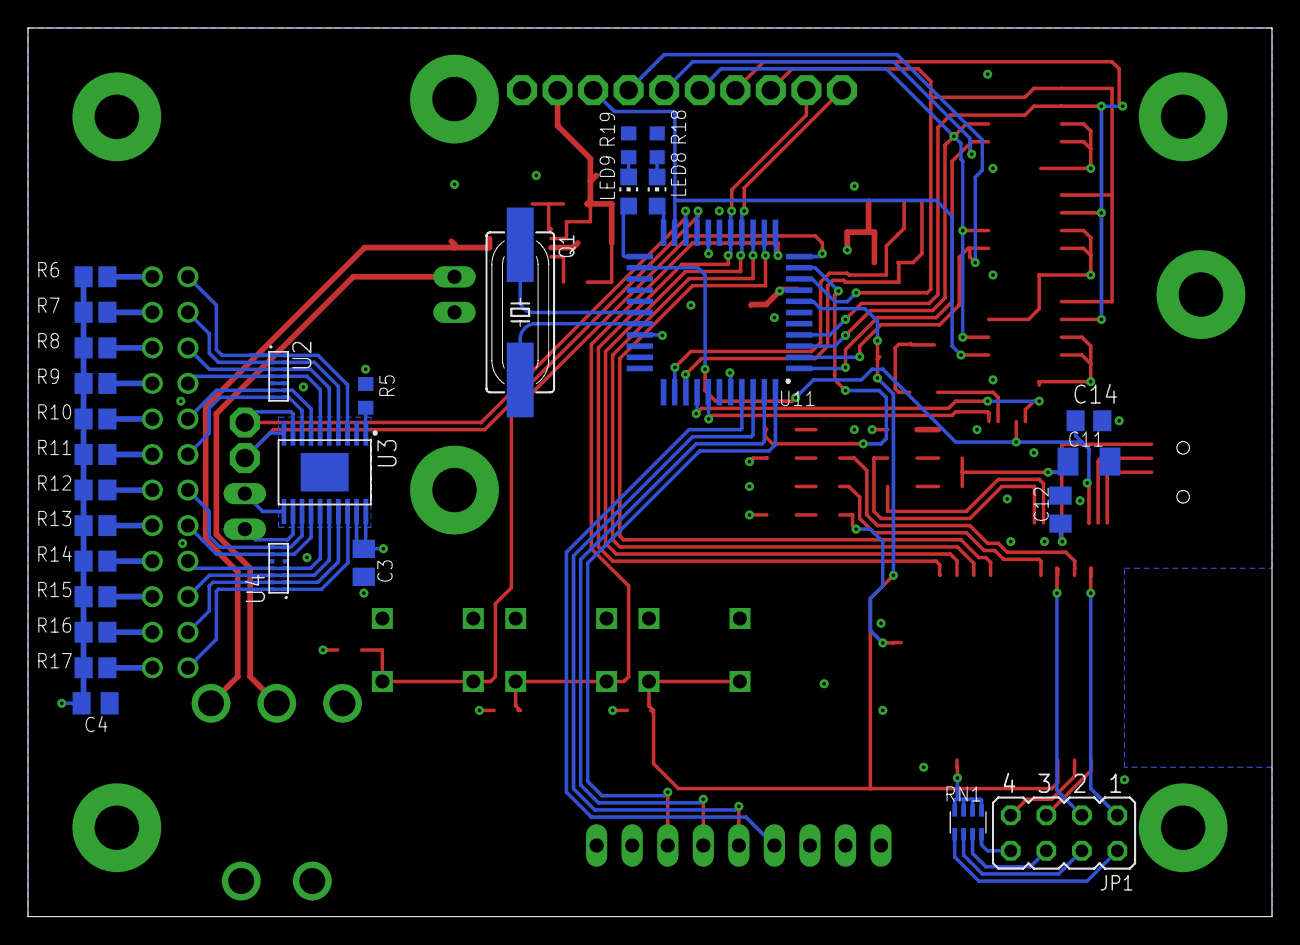
[picture p49: board integrated_haptic.brd from below]

Board: 4 copper layers, 88.9 x 63.5 mm, 91 parts (29 on the bottom side), 90 nets.
