ricearcane/ti_contest/Hardware/Battery Charger/charger.brd

## EAGLE design Hardware/Battery Charger/charger.brd (2014-05-25)

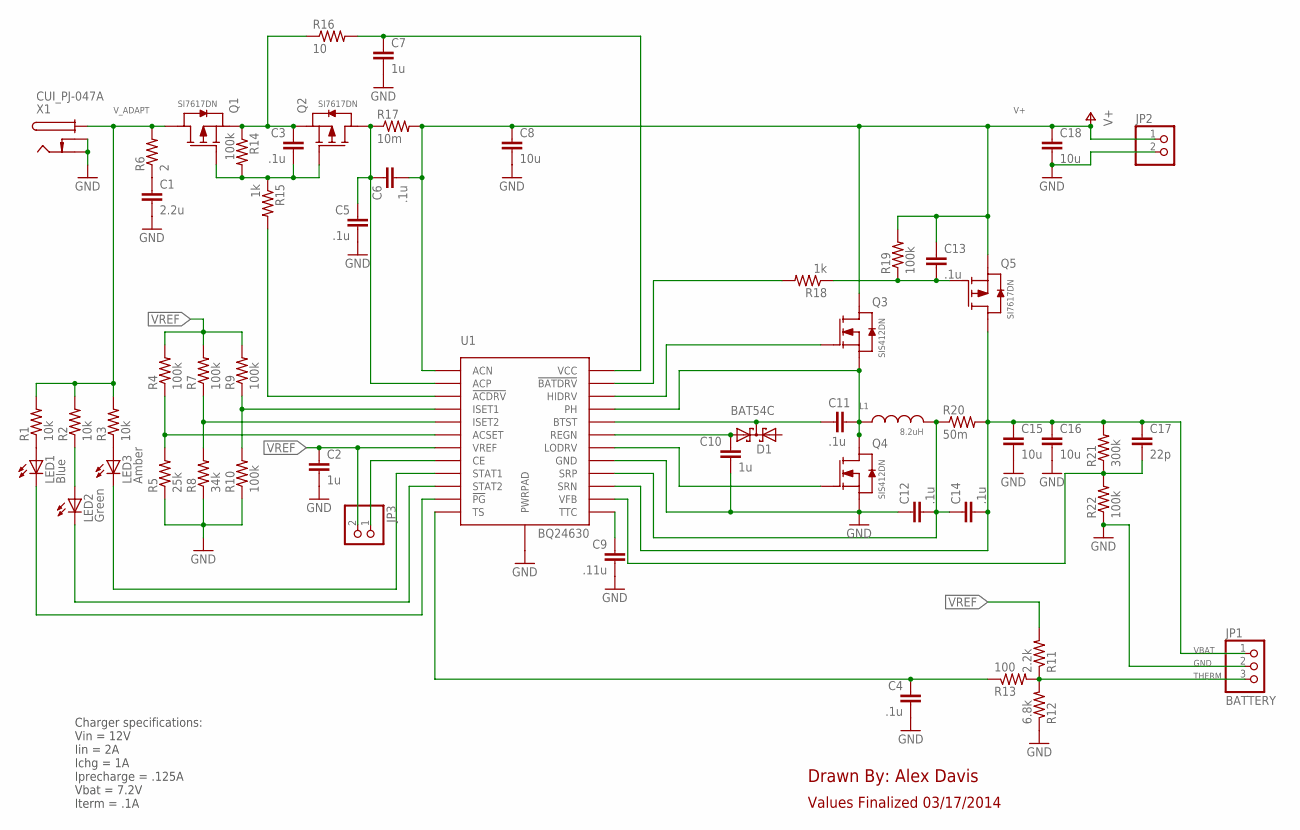
[picture p50: schematic charger.sch]

Parts:
C1: 2.2u; C0603
C2, C7, C10: 1u; C0603
C3, C4, C5, C6, C11, C12, C13, C14: .1u; C0603
C8, C15, C16, C18: 10u; C0805
C9: .11u; C0603
C17: 22p; C0603
D1: BAT54C; SOT23
JP1: BATTERY; 1X03
JP2, JP3: PINHD-1X2; 1X02
L1: 8.2uH; IHLP-2525CZ
LED1: Blue; CHIPLED_0805
LED2: Green; CHIPLED_0805
LED3: Amber; CHIPLED_0805
Q1, Q2, Q5: SI7617DN; POWERPAK1212-8
Q3, Q4: SIS412DN; POWERPAK1212-8
R1, R2, R3: 10k; R0603
R4, R7, R9, R10, R14, R19, R22: 100k; R0603
R5: 25k; R0603
R6: 2; R2512
R8: 34k; R0603
R11: 2.2k; R0603
R12: 6.8k; R0603
R13: 100; R0603
R15, R18: 1k; R0603
R16: 10; R1206
R17: 10m; R2010
R20: 50m; R2010
R21: 300k; R0603
U1: BQ24630; PVQFN-24
X1: CUI_PJ-047A; PJ-047A

Connections:
!PG: LED1.C, U1.P$8 (!PG)
GND: C1.2, C2.2, C4.2, C5.2, C7.2, C8.2, C9.2, C10.2, C12.1, C15.2, C16.2, C18.2, JP1.2, JP2.2, Q4.P$1 (S), Q4.P$2 (S), Q4.P$3 (S), R5.1, R8.1, R10.1, R12.1, R22.1, U1.P$17 (GND), U1.P$25 (PWRPAD), X1.2, X1.3
unnamed: C3.1, Q1.P$1 (S), Q1.P$2 (S), Q1.P$3 (S), Q2.P$1 (S), Q2.P$2 (S), Q2.P$3 (S), R14.1, R16.1
unnamed: C3.2, Q1.P$4 (G), Q2.P$4 (G), R14.2, R15.1
unnamed: C10.1, D1.2 (A2), U1.P$18 (REGN)
unnamed: C5.1, C6.1, Q2.P$5 (D), Q2.P$6 (D), Q2.P$7 (D), Q2.P$8 (D), Q2.P$9 (D), R17.1, U1.P$2 (ACP)
unnamed: C12.2, C14.1, L1.P$2, R20.1, U1.P$14 (SRP)
unnamed: JP3.1, U1.P$4 (CE)
unnamed: C11.1, D1.3 (CC), U1.P$22 (BTST)
unnamed: Q4.P$4 (G), U1.P$19 (LODRV)
unnamed: Q3.P$4 (G), U1.P$21 (HIDRV)
unnamed: C11.2, L1.P$1, Q3.P$1 (S), Q3.P$2 (S), Q3.P$3 (S), Q4.P$5 (D), Q4.P$6 (D), Q4.P$7 (D), Q4.P$8 (D), Q4.P$9 (D), U1.P$20 (PH)
unnamed: C1.1, R6.1
unnamed: R4.1, R5.2, U1.P$16 (ACSET)
unnamed: R15.2, U1.P$3 (!ACDRV)
unnamed: R7.1, R8.2, U1.P$15 (ISET2)
unnamed: R9.1, R10.2, U1.P$11 (ISET1)
unnamed: LED1.A, R1.1
unnamed: LED2.A, R2.1
unnamed: LED3.A, R3.1
unnamed: C4.1, R13.1, U1.P$6 (TS)
unnamed: C9.1, U1.P$7 (TTC)
unnamed: C17.2, R21.1, R22.2, U1.P$12 (VFB)
unnamed: R18.2, U1.P$23 (!BATDRV)
unnamed: C13.2, Q5.P$4 (G), R18.1, R19.1
STAT1: LED3.C, U1.P$5 (STAT1)
STAT2: LED2.C, U1.P$9 (STAT2)
THERM: JP1.3, R11.1, R12.2, R13.2
V+: C6.2, C8.1, C13.1, C18.1, JP2.1, Q3.P$5 (D), Q3.P$6 (D), Q3.P$7 (D), Q3.P$8 (D), Q3.P$9 (D), Q5.P$1 (S), Q5.P$2 (S), Q5.P$3 (S), R17.2, R19.2, U1.P$1 (ACN)
VBAT: C14.2, C15.1, C16.1, C17.1, JP1.1, Q5.P$5 (D), Q5.P$6 (D), Q5.P$7 (D), Q5.P$8 (D), Q5.P$9 (D), R20.2, R21.2, U1.P$13 (SRN)
VCC: C7.1, R16.2, U1.P$24 (VCC)
VREF: C2.1, JP3.2, R4.2, R7.2, R9.2, R11.2, U1.P$10 (VREF)
V_ADAPT: Q1.P$5 (D), Q1.P$6 (D), Q1.P$7 (D), Q1.P$8 (D), Q1.P$9 (D), R1.2, R2.2, R3.2, R6.2, X1.1

Notes on the sheet:
Drawn By: Alex Davis
Charger specifications: Vin = 12V Iin = 2A Ichg = 1A Iprecharge = .125A Vbat = 7.2V Iterm = .1A
Values Finalized 03/17/2014

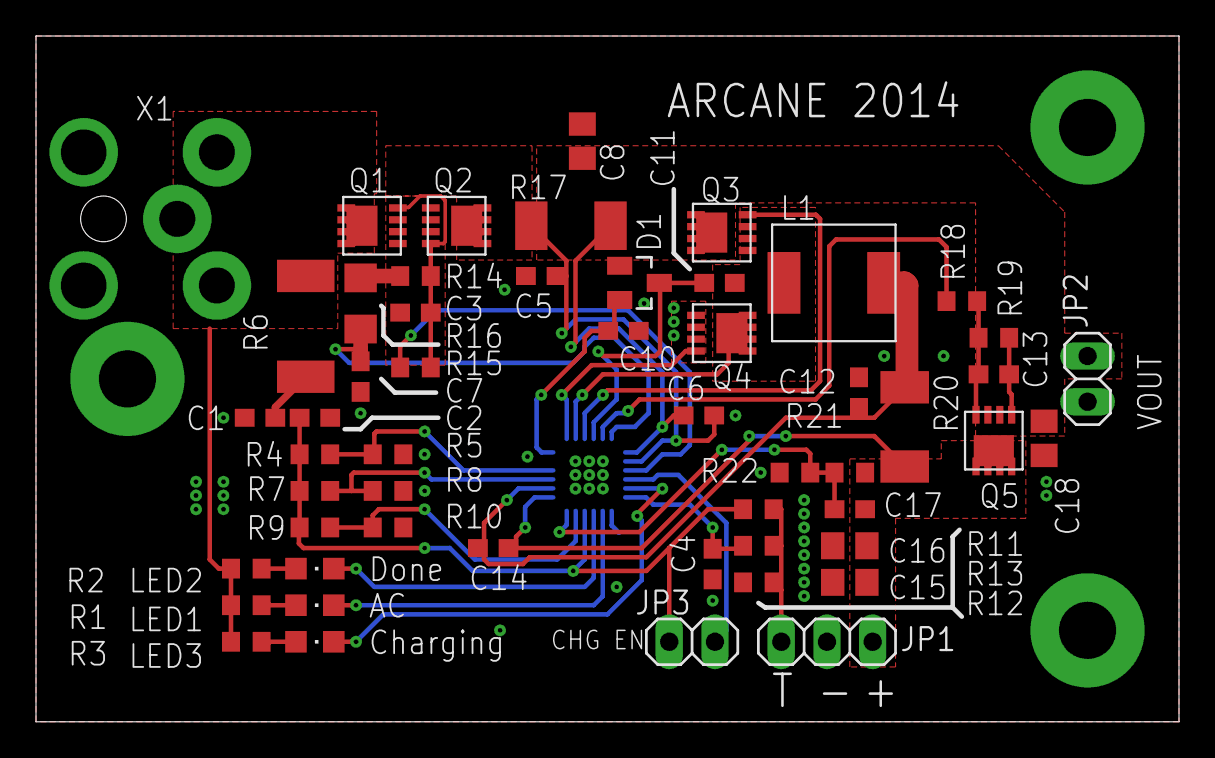
[picture p51: board charger.brd from above]

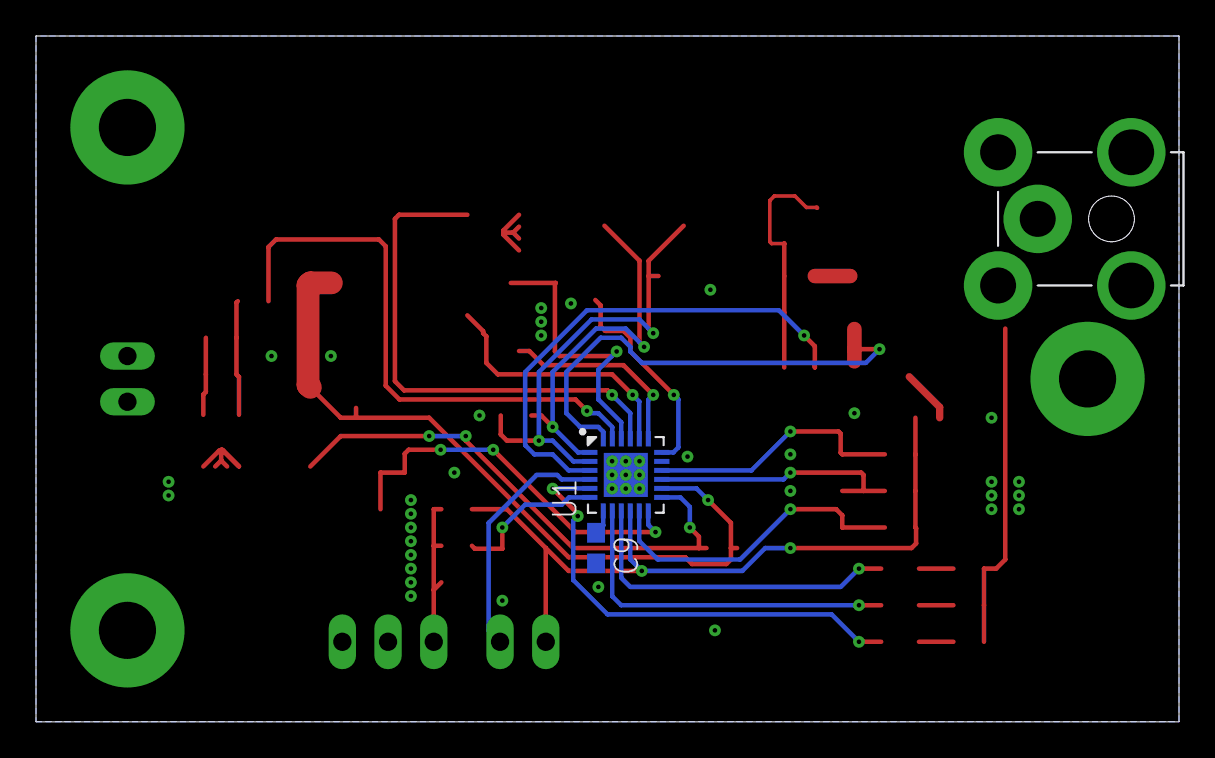
[picture p52: board charger.brd from below]

Board: 2 copper layers, 63.5 x 38.1 mm, 55 parts (3 on the bottom side), 33 nets.
