ricearcane/ti_contest/Software/Haptics/bdriver.h

/*
 * bdriver.h - Adds pushbutton functionality
 */

 #ifndef BDRIVER_H_INCLUDED
 #define BDRIVER_H_INCLUDED

 #include "config.h"

 // Global variable to keep track of button states
 extern int buttonstates;

 // Launch the button routine
 void launch_b();

 #endif
