ricearcane/ti_contest/(commit log)

2014-05-25 Added report and hardware files
    [battery_charger_bom.xlsx, charger.brd, charger.sch, coupon.brd, coupon.sch, integrated_board_bom.xlsx, integrated_haptic.brd, integrated_haptic.sch]
2014-05-25 Added software
    For haptics and sensors
    [stereocalib_box_320_3.yml]
2014-05-25 Added current haptic code files
    Some late compass code changes needed to be added
